MarginallyClever/Daisy-Driver-2.0-firmware/PCB/additional 3D/User Library-Fuse 1812.step

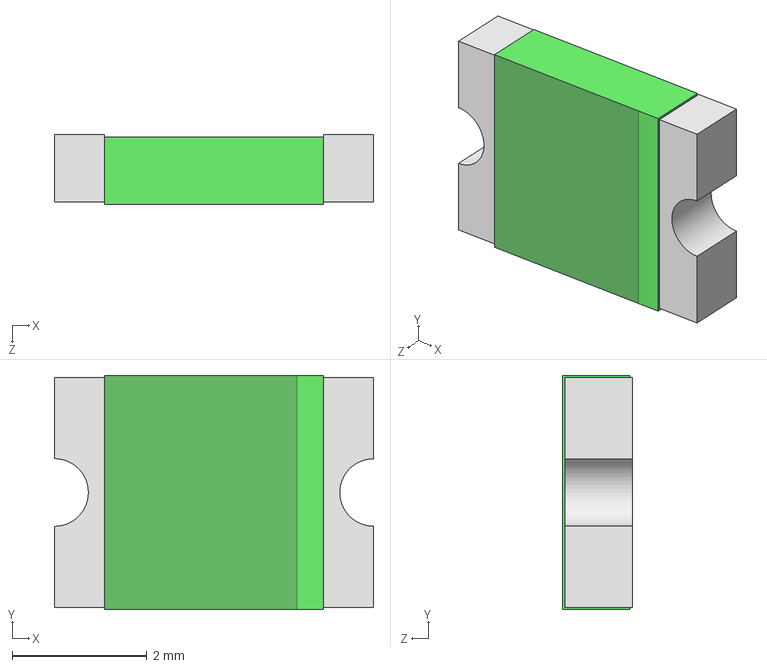
[picture p1: CAD file, 2023-03-13]
PCB/additional 3D/User Library-Fuse 1812.step
4.74 x 3.48 x 1.04 mm
