MarginallyClever/Daisy-Driver-2.0-firmware/PCB/additional 3D/User Library-DO-219AD.STEP

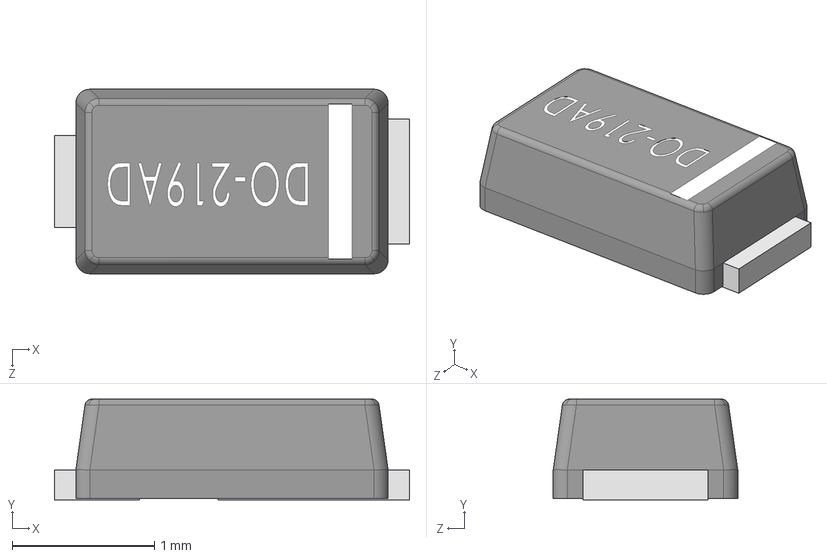
[picture p2: CAD file, 2023-03-13]
PCB/additional 3D/User Library-DO-219AD.STEP
2.50 x 0.71 x 1.30 mm
