MarginallyClever/Daisy-Driver-2.0-firmware/PCB/additional 3D/u254-051n-4bh24-s2s.stp

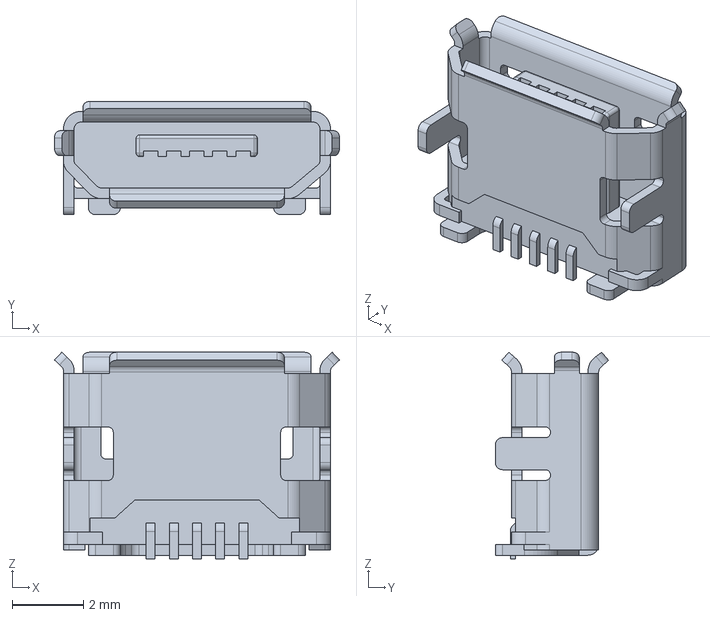
[picture p3: CAD file, 2023-03-13]
PCB/additional 3D/u254-051n-4bh24-s2s.stp
8.00 x 3.18 x 5.80 mm
