MarginallyClever/Daisy-Driver-2.0-firmware/PCB/additional 3D/User Library-CFPS-69.STEP

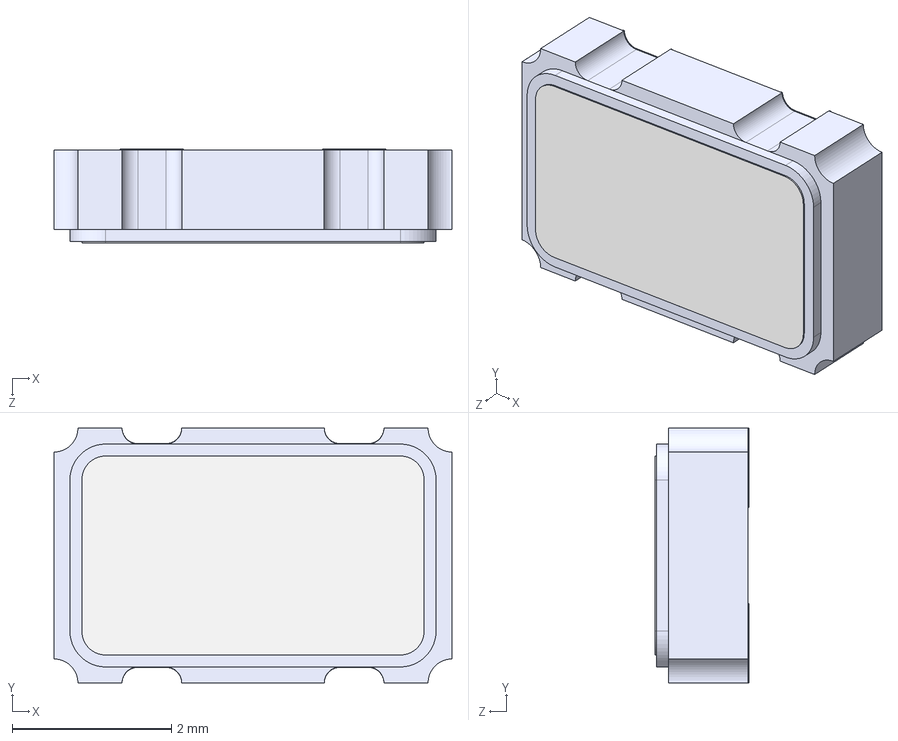
[picture p4: CAD file, 2023-03-13]
PCB/additional 3D/User Library-CFPS-69.STEP
5.00 x 3.20 x 1.18 mm
Imported x 3
Pin
