MarginallyClever/Daisy-Driver-2.0-firmware/PCB/additional 3D/User Library-E-Switch - TL3330AF130QG (Tact Switch, SMD).step

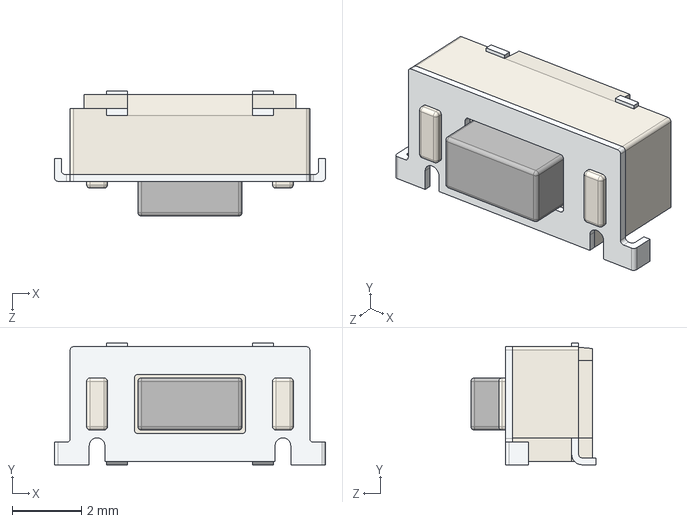
[picture p5: CAD file, 2023-03-13]
PCB/additional 3D/User Library-E-Switch - TL3330AF130QG (Tact Switch, SMD).step
7.80 x 3.50 x 3.60 mm
