MarginallyClever/Daisy-Driver-2.0-firmware/PCB/additional 3D/User Library-2 Way PCB Screw Terminal Block 5_08mm.STEP

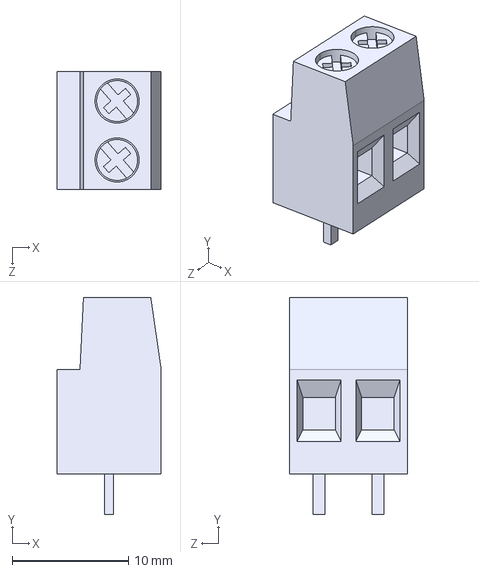
[picture p6: CAD file, 2023-03-13]
PCB/additional 3D/User Library-2 Way PCB Screw Terminal Block 5_08mm.STEP
9.00 x 18.7 x 10.2 mm
