MarginallyClever/Daisy-Driver-2.0-firmware/PCB/additional 3D/1098611_1776275-2.stp

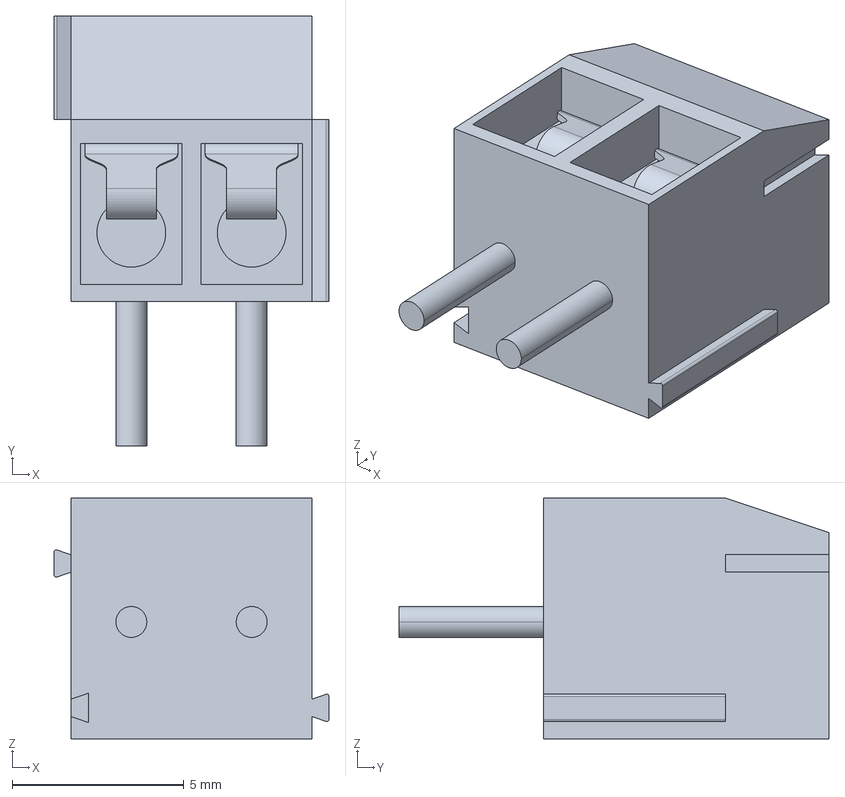
[picture p7: CAD file, 2023-03-13]
PCB/additional 3D/1098611_1776275-2.stp
8.00 x 12.5 x 7.00 mm
