MarginallyClever/Daisy-Driver-2.0-firmware/PCB/additional 3D/70054332.stp

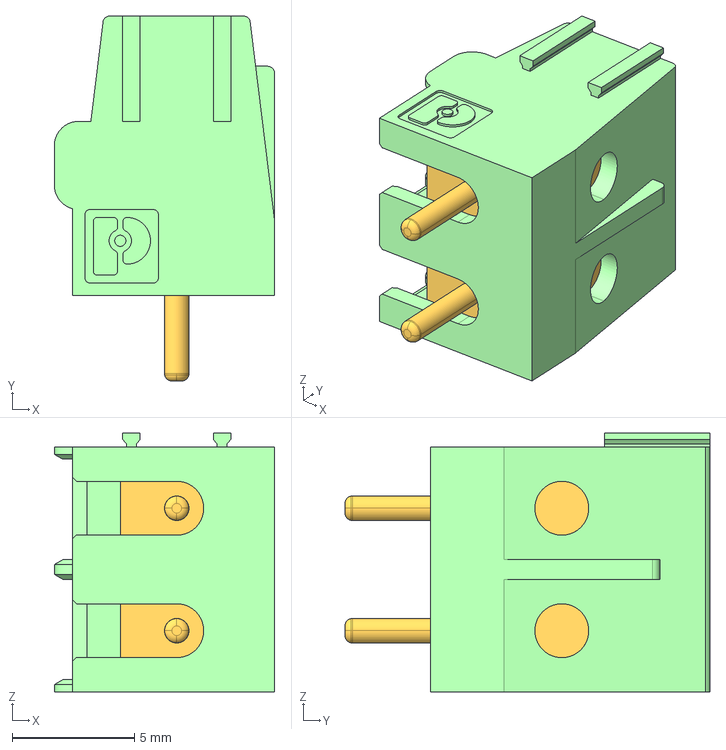
[picture p8: CAD file, 2023-03-13]
PCB/additional 3D/70054332.stp
9.00 x 14.9 x 10.6 mm
