MarginallyClever/Daisy-Driver-2.0-firmware/(list of files, cad)

Other CAD files:
PCB/additional 3D/User Library-3067-47340001R-Rev_01.step
