MarginallyClever/Daisy-Driver-2.0-firmware/(threads)

Thread 1 (2024-05-29):

Question rather than issue?

koepae, 2024-05-29:
Hi Dan!

Which arduino core/ide is used for the daisy driver?

Is the stm32f103 version still available somewhere?

Rgds,
Tapio

i-make-robots, 2024-05-29:
STM32F407.  I don't know where F103 is still available.

i-make-robots, 2024-05-29:
STM32F407.  I don't know where F103 is still available.

Closed 2024-05-29.
