MarginallyClever/Daisy-Driver-2.0-firmware/(commit log)

2023-01-01 move for arduino
2023-01-01 Found a viable BAUD rate and read sensor values
2023-01-02 motor and sensor working together.
2023-01-02 setup 12 bit ADC
2023-02-14 added more CANbus stuff
2023-02-16 moved LED to its own file
2023-03-07 added PCB PDFs for QA
2023-03-13 Added KiCAD files for PCB.
    [1098611_1776275-2.stp, 70054332.stp, DaisyStepperDriver.kicad_pcb, DaisyStepperDriver.kicad_sch, DaisyStepperDriver2.csv, User Library-2 Way PCB Screw Terminal Block 5_08mm.STEP, User Library-3067-47340001R-Rev_01.step, User Library-CFPS-69.STEP]
2023-03-14 replaced PCB with updated design that has fewer vias in pads
    [DaisyStepperDriver.csv, DaisyStepperDriver.kicad_pcb, DaisyStepperDriver.kicad_sch, DaisyStepperDriver2.csv]
2023-03-14 update PCB to version without vias under chips
    [DaisyStepperDriver-B_Cu.gbr, DaisyStepperDriver-B_Mask.gbr, DaisyStepperDriver-B_Paste.gbr, DaisyStepperDriver-B_Silkscreen.gbr, DaisyStepperDriver-Edge_Cuts.gbr, DaisyStepperDriver-F_Cu.gbr, DaisyStepperDriver-F_Mask.gbr, DaisyStepperDriver-F_Paste.gbr]
2023-05-03 updated pcb
    [DaisyStepperDriver.kicad_sch]
2023-05-03 updates for v3 board
2023-05-03 added attribution
    [DaisyStepperDriver.kicad_sch]
2023-05-03 rotated dip switches so zeros are together.
    [DaisyStepperDriver.kicad_pcb, DaisyStepperDriver.kicad_sch]
2023-05-03 fixed reading can pin address
2023-05-03 cleaner CANBus debugging
2023-05-03 ignore kicad backups
2023-05-03 fix full step mode
    [motor.ino]
2023-05-03 fix sending double in big-endian mode.
    [CANBus.ino]
2023-05-07 added STM32CubeIDE project
    basic CANOpen support with parsing NMT, sending heartbeat.
    Update .gitignore
2023-05-07 Revert "added STM32CubeIDE project"
    This reverts commit 8d921a4a0c95486599b7fef09041a52d531bdd8d.
    [CANBus.h, CANBus.ino, CANOpen.h, CANOpen.ino, config.h, memory.ino, pins.h, serial.ino]
2023-05-09 Minimum viable product? crude gcode control over multiple devices.
2023-05-09 put motor on timer interrupt
2023-05-09 set velocity (F) in degrees/s, use new motor ISR.
2023-05-09 better RMS current
2023-05-09 better starting velocity
2023-09-13 idk, kicad did something
2023-09-13 swap SEND and RECEIVE to be the right way around.
    [CANBus.h, application.ino]
2023-09-13 simplify can subindexes, add ability to enumerate devices by CAN ID.
2023-09-13 separate requesting sensor from requesting target position
2023-09-17 Make Motor class
2023-09-19 added FIFO pending interrupt handler.
2023-09-19 disable interrupt by undefining value
2023-09-26 add delay per device to prevent CANbus traffic jams
    [CANBus.h, CANBus.ino, CANParser.h, application.h, application.ino, config.h, daisyDriver.ino]
2023-09-28 added root can make clients reset via software
    [CANBus.ino, CANOpen.h, application.h, application.ino]
